lawsonkeith/Bee-Bot/(list of files, drawings)

Other design files:
Schematic.dsn
