lawsonkeith/Bee-Bot/(threads)

Thread 1 (2017-07-10):

Schematic have an wrong connection...

Akeryone, 2017-07-10:
It is correct the pin XCA connected? Should it be SLC? Thanks

lawsonkeith, 2017-07-11:
Hi

I recall the IMU connections were wrong.  Think one of the data lines went
to the wrong place.

Best regards

Keith

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

--
Best regards

Keith Lawson
