lawsonkeith/Bee-Bot/(commit log)

2015-09-03 Fixed wheel dir bug
    [BBot.ino]
2015-09-03 Improvements to headers
    [Schematic.dsn]
2015-09-04 Added obstacle avoidance
    [Schematic.dsn]
2015-09-04 fixed unreliable button entry, fixed IMU calibration
    [Schematic.dsn]
2015-09-13 motor graph
